lsmxy4/IOT/smartfarm-wiring.png

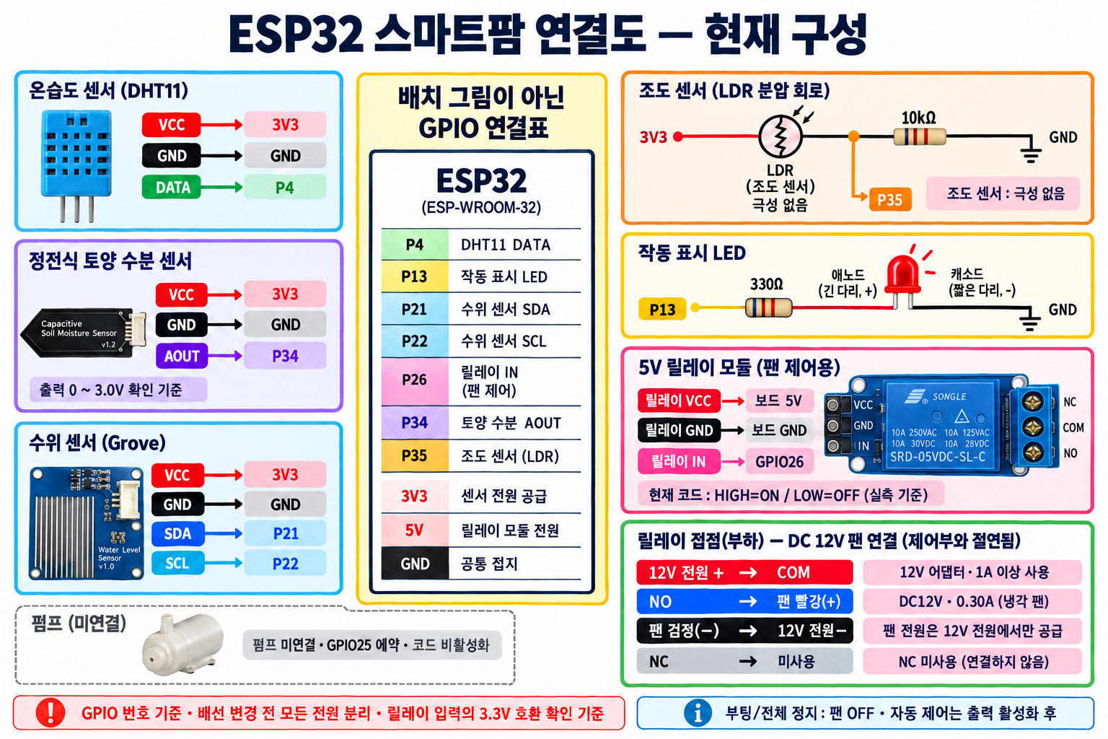
smartfarm-wiring.png
