lsmxy4/IOT/smartfarm-preview.png

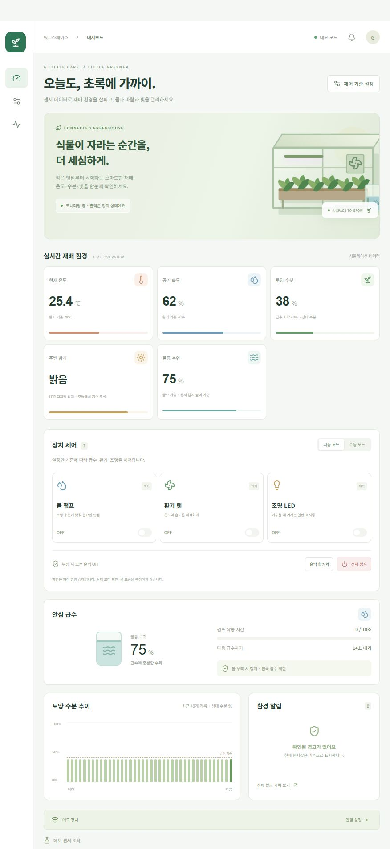
smartfarm-preview.png
