lsmxy4/IOT/docs/smartfarm-physical-wiring.png

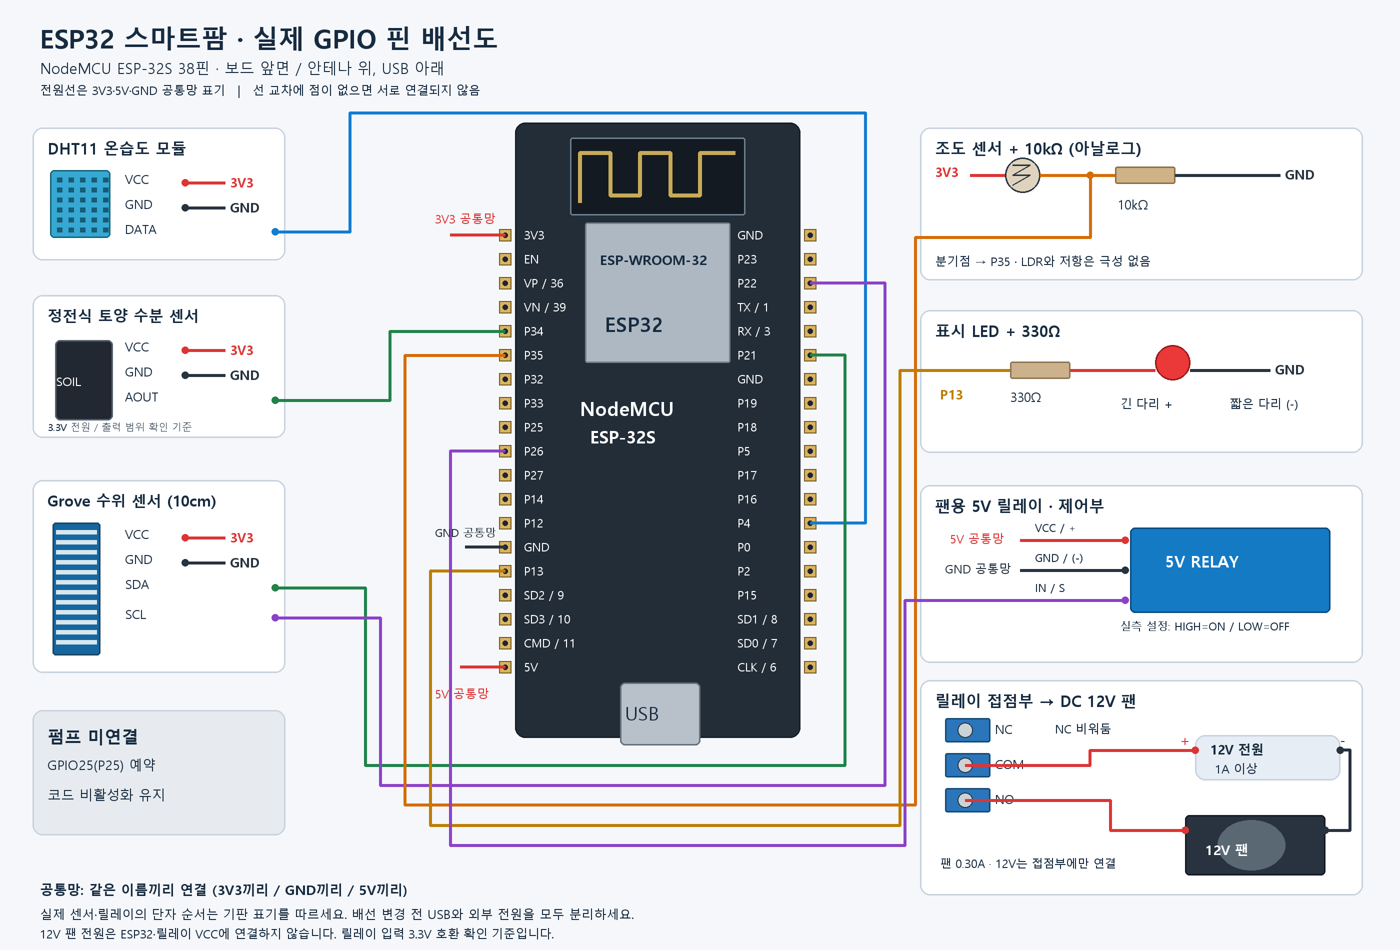
docs/smartfarm-physical-wiring.png
